BaltasarGarcia04/TallerDeIniciacionALosSistemasEmbebidos/README.md

Implementacion de un prototipo de contador de personas automatico utilizando una ESP8266 y laser. Incluye archivo final de presentación del proyecto.
